jeffkub/beer-gauge/README.md

# beer-gauge
Digital scale with display for weighing beer left in a keg/kegerator
