jeffkub/beer-gauge/hardware/beer-gauge-bom.xlsx

Sheet: Main Board
Ref | Description | Source | Part # | Qty | Footprint | Notes
BT1 | HOLDER COIN CELL 12MM SMD | DigiKey | BK-885-CT-ND | 1 | footprint:BK-885
CON1 | CONN PWR JACK 2.0X5.5MM SMD | DigiKey | CP-070AHPJCT-ND | 1 | footprint:PJ-070AH-SMT
C1 | CAP TANT 220UF 16V 10% 2917 | DigiKey | 399-10429-1-ND | 1 | Capacitors_Tantalum_SMD:TantalC_SizeD_EIA-7343_Reflow
C2-C4,C6, C9-C14,C16,C17 | 0.10µF ±10% 25V X7R Ceramic Capacitor | DigiKey | 311-1341-1-ND | 12 | Capacitors_SMD:C_0603
C5,C7,C8,C15 | 2.2µF ±10% 10V X7R Ceramic Capacitor | DigiKey | 311-1797-1-ND | 4 | Capacitors_SMD:C_0603
C18 | CAP TANT 100UF 10V 20% 2917 | DigiKey | 399-3772-1-ND | 1 | Capacitors_Tantalum_SMD:TantalC_SizeD_EIA-7343_Reflow
D1 | LED RED CLEAR 0603 SMD | DigiKey | 754-1123-1-ND | 1 | LEDs:LED_0603
D2 | DIODE ARRAY SCHOTTKY 40V 3HUSON | DigiKey | 568-6524-1-ND | 1 | footprint:SOT1061
D3 | DIODE ZENER 6.2V 500MW SOD123 | DigiKey | DDZ6V2BDICT-ND | 1 | Diodes_SMD:SOD-123
D4 | DIODE GEN PURP 100V 1A SMA | DigiKey | S1B-FDICT-ND | 1 | Diodes_SMD:SMA_Standard
J1 | CONN FPC BOTTOM 20POS 1.00MM R/A | DigiKey | WM7946CT-ND | 2 | footprint:0522712069
L1-L3 | FERRITE BEAD 600 OHM 0603 1LN | DigiKey | 490-1014-1-ND | 3 | Resistors_SMD:R_0603
P1-P4 | CONN MOD JACK 4P4C VERT UNSHLD | DigiKey | WM3555CT-ND | 4 | footprint:0855135016
P5 | USB - micro B USB 2.0 Receptacle | DigiKey | 609-4613-1-ND | 1 | footprint:10118192
R1,R4,R5 | RES SMD 470 OHM 1% 1/10W 0603 | DigiKey | 311-470HRCT-ND | 3 | Resistors_SMD:R_0603
R2,R3 | RES SMD 33 OHM 1% 1/10W 0603 | DigiKey | 311-33.0HRCT-ND | 2 | Resistors_SMD:R_0603
R6-R13 | RES SMD 4.7K OHM 1% 1/10W 0603 | DigiKey | 311-4.70KHRCT-ND | 8 | Resistors_SMD:R_0603
SP1 | BUZZER PIEZO 12.5V 9MM SMD | DigiKey | 490-9647-1-ND | 1 | footprint:PKMCS
SW1 | SWITCH TACTILE SPST-NO 0.05A 32V | DigiKey | CKN10284CT-ND | 1 | Buttons_Switches_SMD:SW_SPST_KMR2
U1 | IC ADC 24-BIT 10/80SPS 24-TSSOP | DigiKey | 296-25894-1-ND | 1 | Housings_SSOP:TSSOP-24_4.4x7.8mm_Pitch0.65mm
U2 | IC REG LDO 3.3V 0.5A 6WSON | DigiKey | 296-42346-1-ND | 1 | Housings_DFN_QFN:DFN-6-1EP_3x3mm_Pitch0.95mm
U3 | MKL02 chip pre-programmed with Teensy bootloader | PJRC | IC_MKL02Z32_QFN16 | 1 | Housings_DFN_QFN:QFN-16-1EP_3x3mm_Pitch0.5mm | https://www.pjrc.com/store/ic_mkl02.html
U4 | IC MCU 32BIT 256KB FLASH 64LQFP | DigiKey | MK20DX256VLH7-ND | 1 | Housings_QFP:LQFP-64_10x10mm_Pitch0.5mm
U5 | IC I2C SW 2CH W/RESET 14TSSOP | DigiKey | 296-42157-1-ND | 1 | Housings_SSOP:TSSOP-14_4.4x5mm_Pitch0.65mm
U6 | IC MULT-FUNCTION GATE SC70-6 | DigiKey | 296-15577-1-ND | 1 | TO_SOT_Packages_SMD:SC-70-6
Y1 | 16MHz ±15ppm Crystal 8pF | DigiKey | 644-1049-1-ND | 1 | Crystals:Crystal_SMD_2520_4Pads
Y2 | 32.768kHz ±20ppm Crystal 12.5pF | DigiKey | 535-9542-1-ND | 1 | footprint:ABS07
- | CABLE FFC 1MM TYPE 2 20P100MM | DigiKey | 732-5134-ND | 1
- | BATTERY LITHIUM 3V COIN 12.5MM | DigiKey | P033-ND | 1
- | Monochrome 2.42" 128x64 OLED Graphic Display Module Kit | Adafruit | 2719 | 1 | https://www.adafruit.com/product/2719

Sheet: Sensor Board
Ref | Description | Source | Part # | Qty | Footprint | Notes
C1,C2 | 2.2µF ±10% 10V X7R Ceramic Capacitor | DigiKey | 311-1797-1-ND | 2 | Capacitors_SMD:C_0603
C3,C4 | 0.10µF ±10% 25V X7R Ceramic Capacitor | DigiKey | 311-1341-1-ND | 2 | Capacitors_SMD:C_0603
P1 | CONN MOD JACK 4P4C R/A UNSHLD | DigiKey | WM3544CT-ND | 1
R3,R4 | RES SMD 4.7K OHM 1% 1/10W 0603 | DigiKey | 311-4.70KHRCT-ND | 2 | Resistors_SMD:R_0603
U1 | IC REG LDO 3.3V 0.5A 6WSON | DigiKey | 296-42346-1-ND | 1 | Housings_DFN_QFN:DFN-6-1EP_3x3mm_Pitch0.95mm
U2 | SENSOR TEMP I2C/SMBUS 8DFN | DigiKey | MCP9808T-E/MCCT-ND | 1
U3 | SENSOR PRESSURE 30 PSIG | DigiKey | 480-6247-ND | 1
