jeffkub/beer-gauge/enclosure/EnclosureLaserCut.dxf

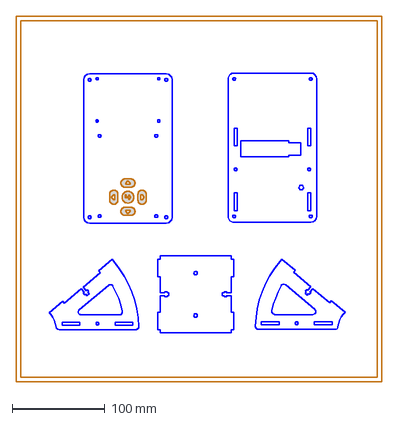
[picture p1: CAD file, 2016-07-14]
enclosure/EnclosureLaserCut.dxf
394.0 x 394.0 mm
