jeffkub/beer-gauge/(list of files, cad)

Other CAD files:
enclosure/BackCover.ipt
enclosure/EnclosureAssembly.iam
enclosure/EnclosureDrawing.idw
enclosure/FrontCover.ipt
enclosure/Magnet.ipt
enclosure/MountBase.ipt
enclosure/SideMount.ipt
