jeffkub/beer-gauge/hardware/beer-gauge.pdf

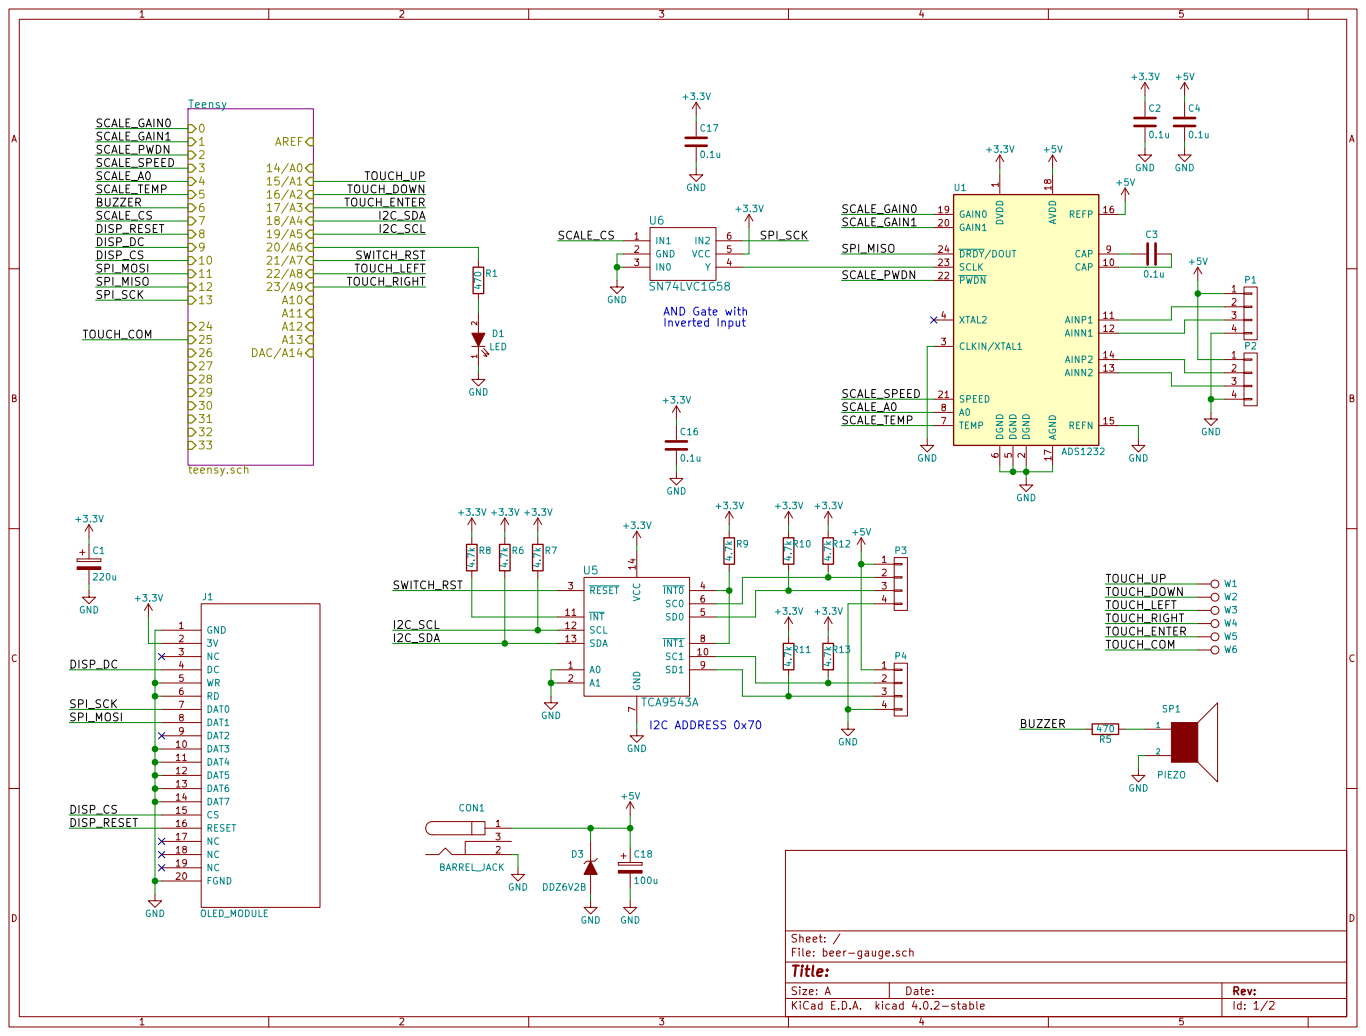
[picture p2: page 1]

6 TEMP 7 A0 8 CAP 9 CAP 10 GAIN1 20 AINP1 11 SPEED 21 AINN1 12 PWDN 22 AINN2 13 SCLK 23 AINP2 14 DRDY/DOUT 24 REFN 15 REFP 16 AGND 17 AVDD 18 GAIN0 19 U1 ADS1232 GND
SCALE_GAIN0
SCALE_GAIN1

TOUCH_LEFT
TOUCH_RIGHT

I2C_SDA

File: beer-gauge.sch Sheet: /

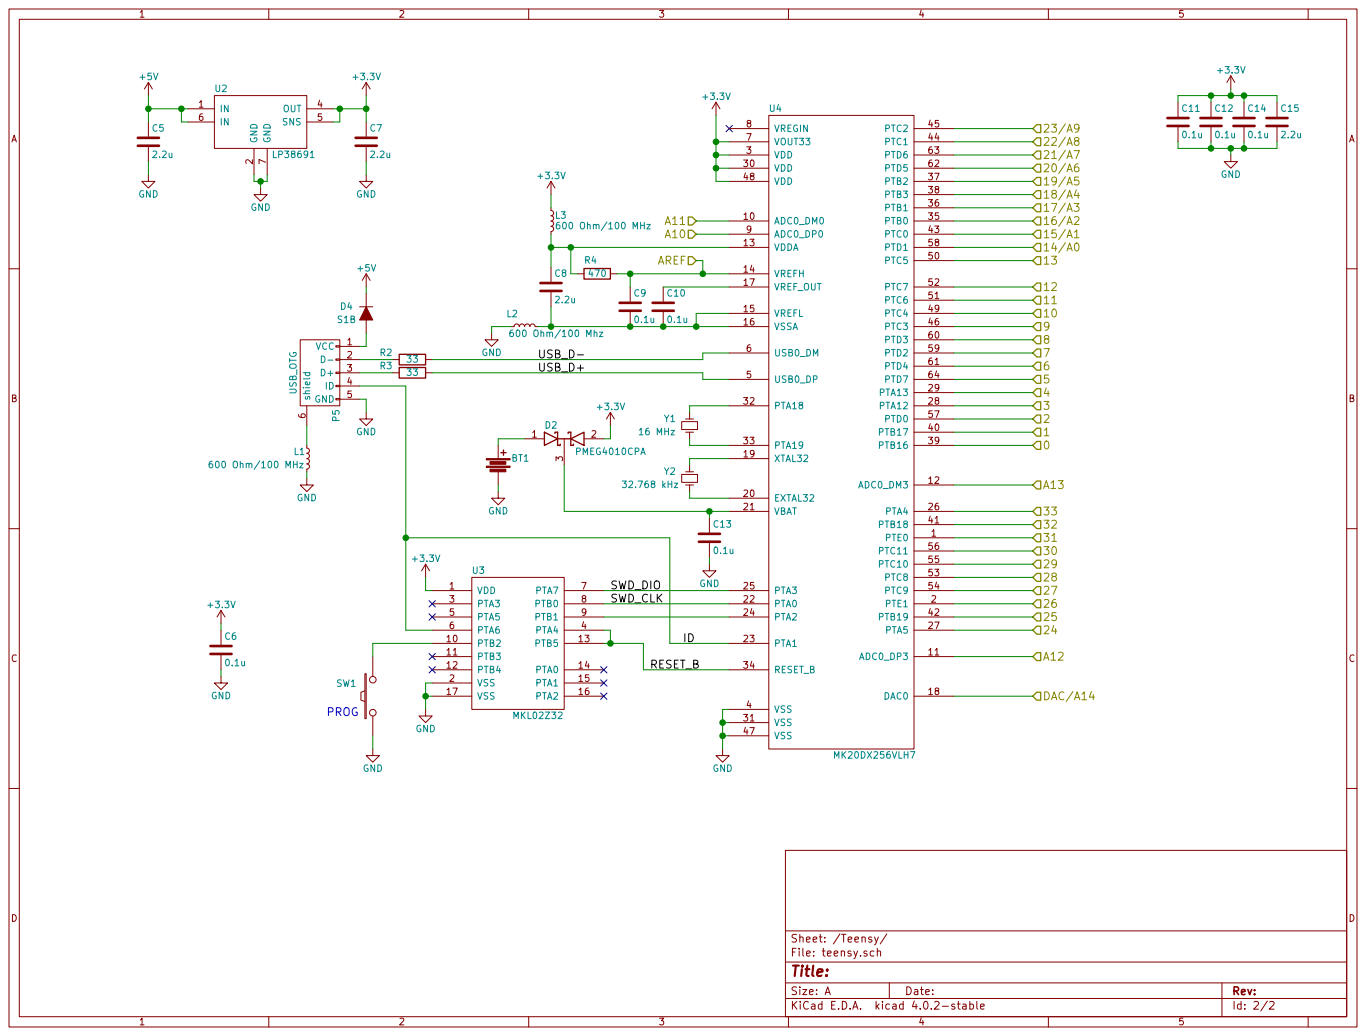
[picture p3: page 2]
