jeffkub/beer-gauge/sensorboard/sensorboard.pdf

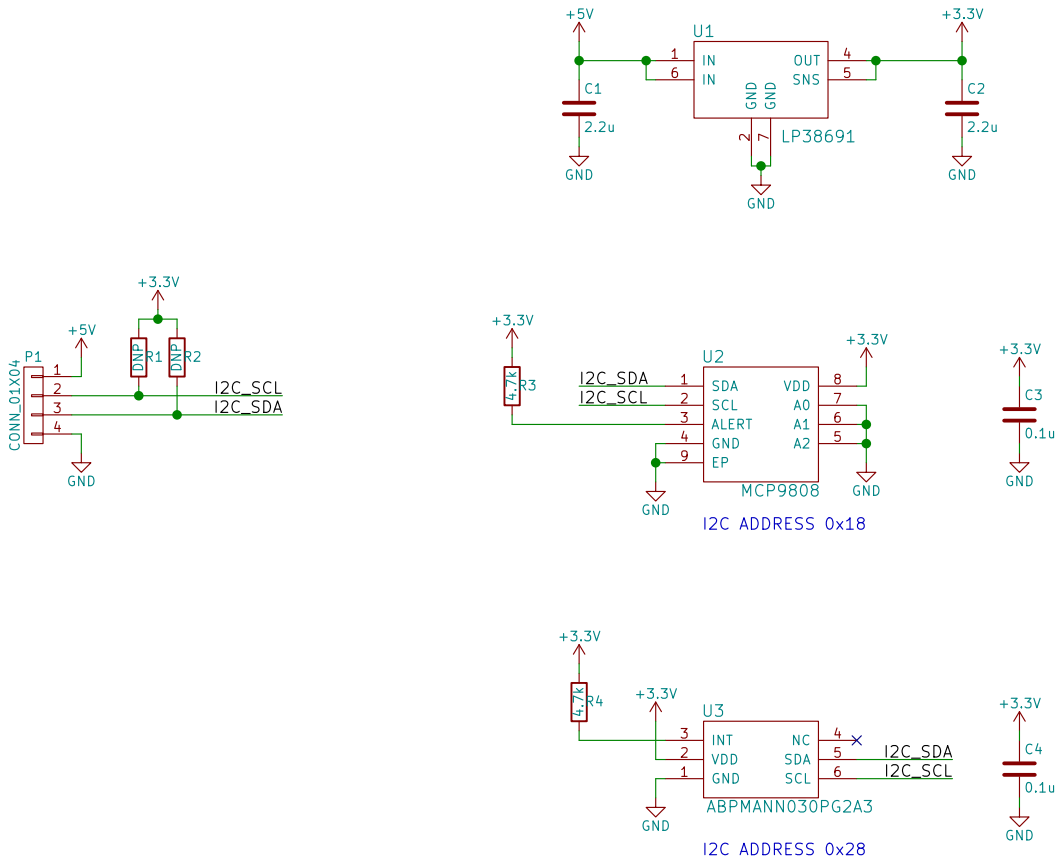
[picture p4: page 1]

I2C_SCL

Id: 1/1 Title: File: sensorboard.sch Sheet: /
