jeffkub/beer-gauge/sensorboard/sensorboard.kicad_pcb

## KiCad design sensorboard/sensorboard.kicad_pcb (2016-07-09)

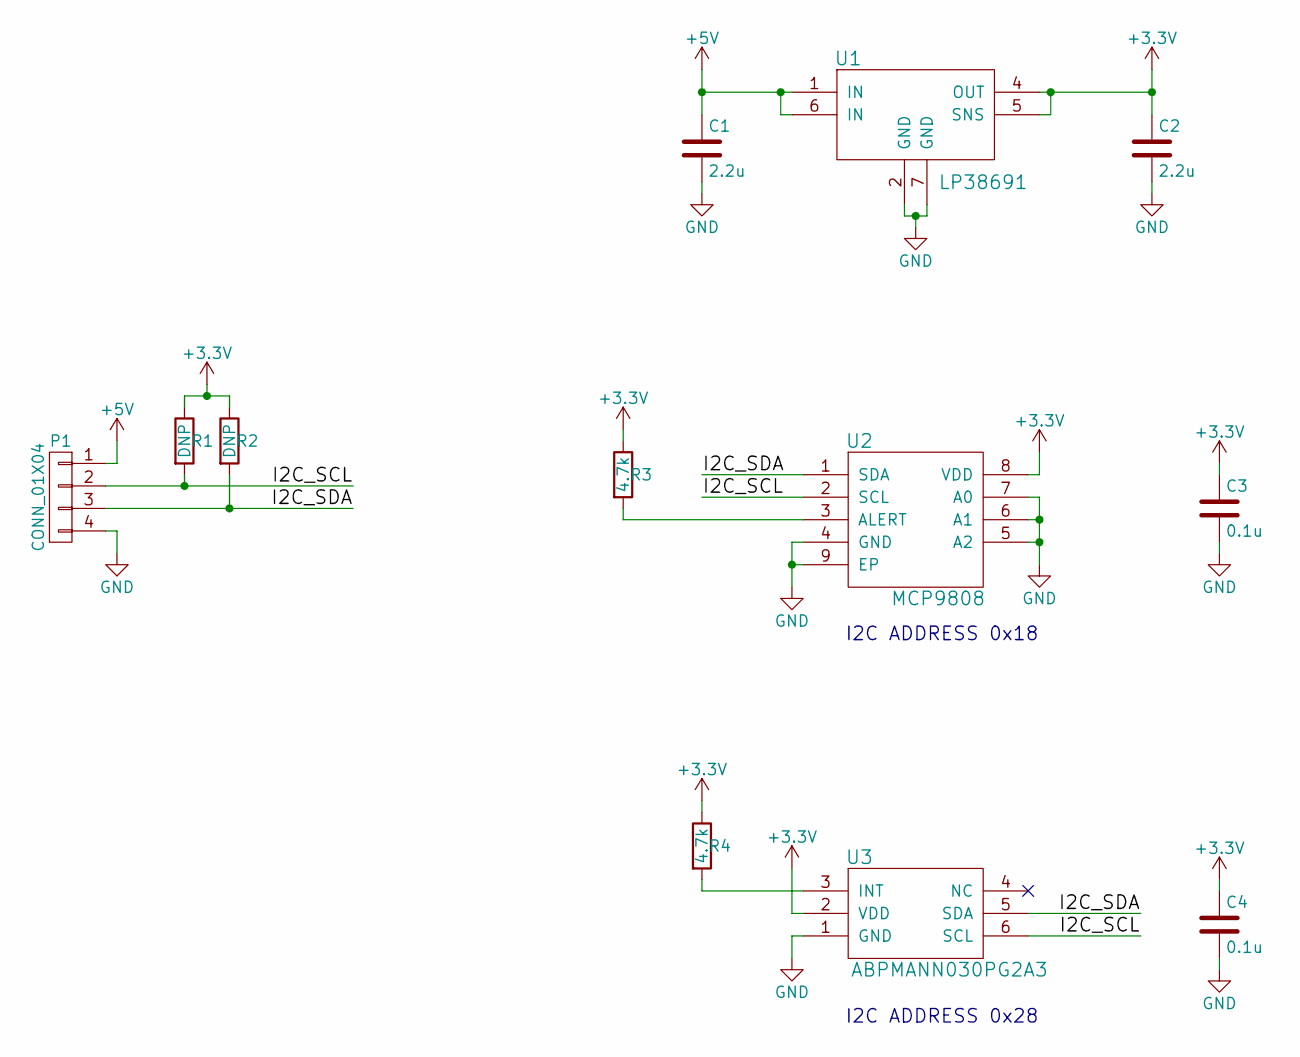
[picture p5: schematic sensorboard.sch]

Parts:
C1, C2: 2.2u; C_0603
C3, C4: 0.1u; C_0603
P1: CONN_01X04; 0855025005
R1, R2: DNP; R_0603
R3, R4: 4.7k; R_0603
U1: LP38691; DFN-6-1EP_3x3mm_Pitch0.95mm
U2: MCP9808; DFN-8-1EP_3x2mm_Pitch0.5mm
U3: ABPMANN030PG2A3

Connections:
+3V3: C2.1, C3.1, C4.1, R1.1, R2.1, R3.1, R4.1, U1.4 (OUT), U1.5 (SNS), U2.8 (VDD), U3.2 (VDD)
+5V: C1.1, P1.1, U1.1 (IN), U1.6 (IN)
/I2C_SCL: P1.2, R1.2, U2.2 (SCL), U3.6 (SCL)
/I2C_SDA: P1.3, R2.2, U2.1 (SDA), U3.5 (SDA)
GND: C1.2, C2.2, C3.2, C4.2, P1.4, U1.2 (GND), U1.7 (GND), U2.4 (GND), U2.5 (A2), U2.6 (A1), U2.7 (A0), U2.9 (EP), U3.1 (GND)
unnamed: R3.2, U2.3 (ALERT)
unnamed: R4.2, U3.3 (INT)

Notes on the sheet:
I2C ADDRESS 0x18
I2C ADDRESS 0x28

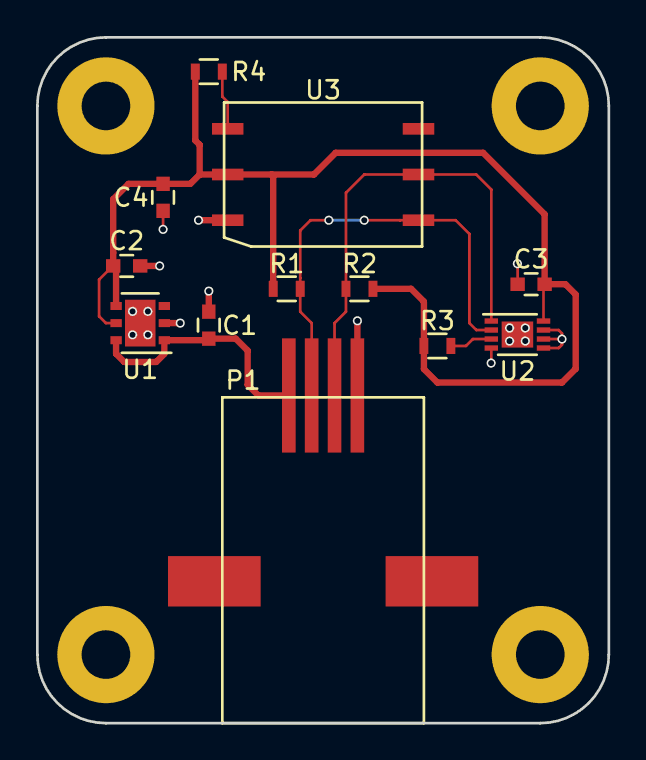
[picture p6: board sensorboard.kicad_pcb from above]

Board: 2 copper layers, 31.8 x 38.1 mm, 12 parts (0 on the bottom side), 7 nets.
