jeffkub/beer-gauge/hardware/beer-gauge.kicad_pcb

## KiCad design hardware/beer-gauge.kicad_pcb (2016-07-09)

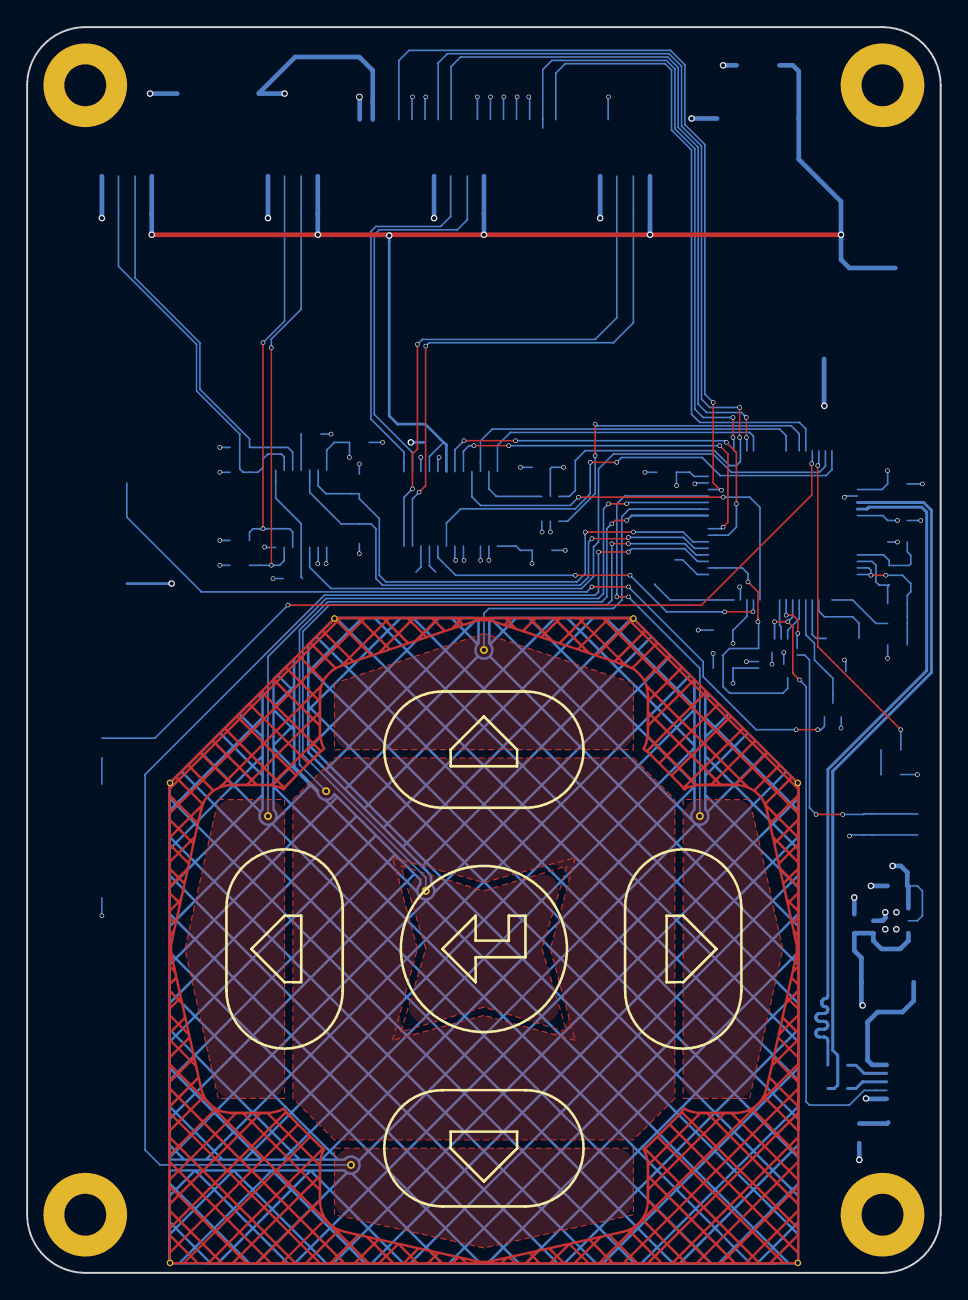
[picture p7: board beer-gauge.kicad_pcb from above]

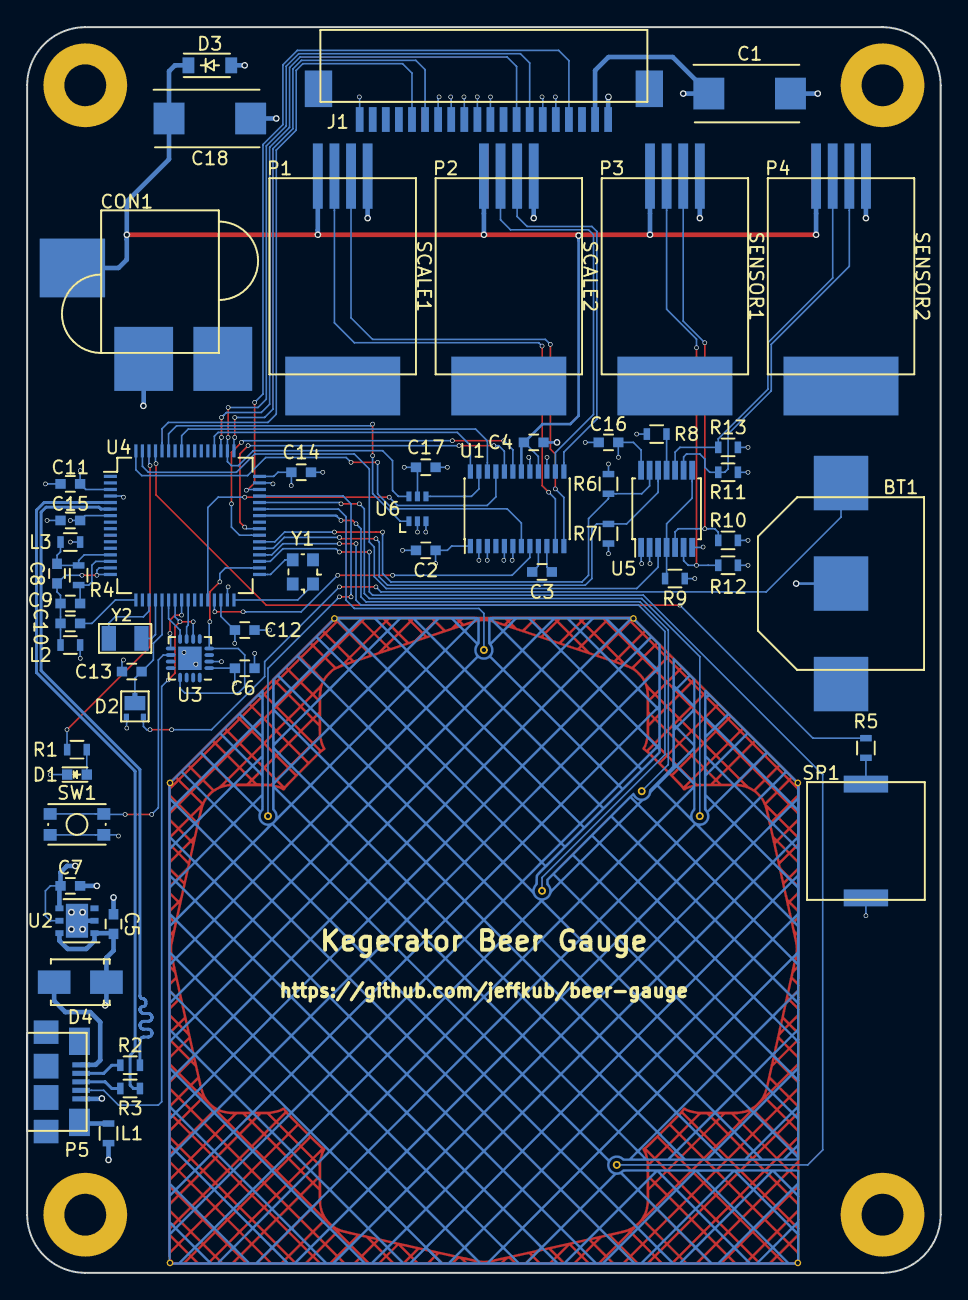
[picture p8: board beer-gauge.kicad_pcb from below]

Board: 4 copper layers, 69.8 x 95.2 mm, 62 parts (56 on the bottom side), 64 nets.

Parts:
BT1: Battery; BK-885
C1: 220u; TantalC_SizeD_EIA-7343_Reflow
C2, C3, C4, C6, C9, C10, C11, C12, C13, C14, C16, C17: 0.1u; C_0603
C5, C7, C8, C15: 2.2u; C_0603
C18: 100u; TantalC_SizeD_EIA-7343_Reflow
CON1: BARREL_JACK; PJ-070AH-SMT
D1: LED; LED_0603
D2: PMEG4010CPA; SOT1061
D3: DDZ6V2B; SOD-123
D4: S1B; SMA_Standard
J1: OLED_MODULE; 0522712069
L1, L3: 600 Ohm/100 MHz; R_0603
L2: 600 Ohm/100 Mhz; R_0603
P1, P2, P3, P4: CONN_01X04; 0855135016
P5: USB_OTG; 10118192
R1, R4, R5: 470; R_0603
R2, R3: 33; R_0603
R6, R7, R8, R9, R10, R11, R12, R13: 4.7k; R_0603
SP1: PIEZO; PKMCS
SW1: SW_PUSH; SW_SPST_KMR2
U1: ADS1232; TSSOP-24_4.4x7.8mm_Pitch0.65mm
U2: LP38691; DFN-6-1EP_3x3mm_Pitch0.95mm
U3: MKL02Z32; QFN-16-1EP_3x3mm_Pitch0.5mm
U4: MK20DX256VLH7; LQFP-64_10x10mm_Pitch0.5mm
U5: TCA9543A; TSSOP-14_4.4x5mm_Pitch0.65mm
U6: SN74LVC1G58; SC-70-6
W1, W2, W3, W4, W5, W6: TEST_1P; PadVia
Y1: 16 MHz; Crystal_SMD_2520_4Pads
Y2: 32.768 kHz; ABS07

Connections:
+3V3: C1.1, C2.1, C6.1, C7.1, C11.1, C12.1, C14.1, C15.1, C16.1, C17.1, D2.2, J1.2, L3.1, R6.1, R7.1, R8.1, R9.1, R10.1, R11.1, R12.1, R13.1, U1.1, U2.4, U2.5, U3.1, U4.3, U4.7, U4.30, U4.48, U5.14, U6.5
+5V: C4.1, C5.1, C18.1, CON1.1, D3.1, D4.1, P1.1, P2.1, P3.1, P4.1, U1.16, U1.18, U2.1, U2.6
/Teensy/0: U1.19, U4.39
/Teensy/1: U1.20, U4.40
/Teensy/2: U1.22, U4.57
/Teensy/3: U1.21, U4.28
/Teensy/4: U1.8, U4.29
/Teensy/5: U1.7, U4.64
/Teensy/6: R5.2, U4.61
/Teensy/7: U4.59, U6.1
/Teensy/8: J1.16, U4.60
/Teensy/9: J1.4, U4.46
/Teensy/10: J1.15, U4.49
/Teensy/11: J1.8, U4.51
/Teensy/12: U1.24, U4.52
/Teensy/13: J1.7, U4.50, U6.6
/Teensy/15/A1: U4.43, W1.1
/Teensy/16/A2: U4.35, W2.1
/Teensy/17/A3: U4.36, W5.1
/Teensy/18/A4: R6.2, U4.38, U5.13
/Teensy/19/A5: R7.2, U4.37, U5.12
/Teensy/20/A6: R1.1, U4.62
/Teensy/21/A7: U4.63, U5.3
/Teensy/22/A8: U4.44, W3.1
/Teensy/23/A9: U4.45, W4.1
/Teensy/25: U4.42, W6.1
/Teensy/AREF: C9.1, R4.1, U4.14
/Teensy/ID: P5.4, U3.6, U4.23
/Teensy/RESET_B: U3.4, U3.13, U4.34
/Teensy/SWD_CLK: U3.8, U4.22
/Teensy/SWD_DIO: U3.7, U4.25
/Teensy/USB_D+: R3.1, U4.5
/Teensy/USB_D-: R2.1, U4.6
GND: BT1.2, C1.2, C2.2, C4.2, C5.2, C6.2, C7.2, C11.2, C12.2, C13.2, C14.2, C15.2, C16.2, C17.2, C18.2, CON1.2, D1.1, D3.2, J1.1, J1.5, J1.6, J1.10, J1.11, J1.12, J1.13, J1.14, J1.20, L1.2, L2.1, P1.4, P2.4, P3.4, P4.4, P5.5, SP1.2, SW1.1, U1.2, U1.3, U1.5, U1.6, U1.15, U1.17, U2.2, U2.7, U3.2, U3.17, U4.4, U4.31, U4.47, U5.1, U5.2, U5.7, U6.2, U6.3
unnamed: BT1.1, D2.1
unnamed: C3.1, U1.9
unnamed: C3.2, U1.10
unnamed: C8.1, L3.2, R4.2, U4.13
unnamed: C10.1, U4.17
unnamed: C8.2, C9.2, C10.2, L2.2, U4.15, U4.16
unnamed: C13.1, D2.3, U4.21
unnamed: D1.2, R1.2
unnamed: D4.2, P5.1
unnamed: L1.1, P5.6
unnamed: P1.2, U1.11
unnamed: P1.3, U1.12
unnamed: P2.2, U1.14
unnamed: P2.3, U1.13
unnamed: P3.2, R12.2, U5.6
unnamed: P3.3, R10.2, U5.5
unnamed: P4.2, R13.2, U5.10
unnamed: P4.3, R11.2, U5.9
unnamed: P5.2, R2.2
unnamed: P5.3, R3.2
unnamed: R5.1, SP1.1
unnamed: R8.2, U5.11
unnamed: R9.2, U5.4, U5.8
unnamed: SW1.2, U3.10
unnamed: U1.23, U6.4
unnamed: U3.9, U4.24
unnamed: U4.19, Y2.1
unnamed: U4.20, Y2.2
unnamed: U4.32, Y1.1
unnamed: U4.33, Y1.2
