jeffkub/beer-gauge/(commit log)

2016-06-11 Initial commit of KiCad project
    [beer-gauge.kicad_pcb, beer-gauge.sch]
2016-06-14 Created TEENSY footprint
    [beer-gauge.sch]
2016-06-16 Added subsheet for TEENSY schematic. Working on TEENSY circuit based on online reference design.
    [beer-gauge.sch, teensy.sch]
2016-06-17 Working on schematic
    [beer-gauge.sch, teensy.sch]
2016-06-17 Created schematic PDF. Working on BOM.
    [BillOfMaterials.xlsx, beer-gauge.sch, teensy.sch]
2016-06-19 Working on BOM.
    [BillOfMaterials.xlsx, beer-gauge-bom.xlsx, beer-gauge.sch, teensy.sch]
2016-06-19 Added piezo transducer. Working on footprints
    [beer-gauge-bom.xlsx, beer-gauge.sch, teensy.sch]
2016-06-19 Working on capacitive touch pad. Added footprint for piezo
    [beer-gauge-bom.xlsx, beer-gauge.sch, teensy.sch]
2016-06-20 Added footprint for coin cell battery holder and RJ10 jack
    [beer-gauge-bom.xlsx, beer-gauge.sch, teensy.sch]
2016-06-21 Working on footprints. Exported netlist into layout.
    [beer-gauge-bom.xlsx, beer-gauge.kicad_pcb, beer-gauge.sch, teensy.sch]
2016-06-22 Finished footprints. Switched to a tantalum cap for the LCD. Changed piezo resistor value to 470 to reduce part count.
    [beer-gauge-bom.xlsx, beer-gauge.kicad_pcb, beer-gauge.sch]
2016-06-22 Working on capacitive touch arrow pad layout
    [beer-gauge.kicad_pcb]
2016-06-23 Working on component placement
    [beer-gauge.kicad_pcb]
2016-06-24 Working on PCB layout
    [beer-gauge.kicad_pcb]
2016-06-26 Finished routing traces
    [beer-gauge.kicad_pcb]
2016-06-26 Finished routing the board
    [beer-gauge.kicad_pcb]
2016-06-27 Added RTC battery to BOM. Fixed BOM quantities
    [beer-gauge-bom.xlsx]
2016-06-27 Initial commit of arduino code
2016-06-30 Working on ADC driver library
2016-06-30 Added some silkscreen text. Adjusted soldermask clearance as it was too large.
    [beer-gauge.kicad_pcb]
2016-07-06 Changed OLED display to use SPI interface in schematic
    [beer-gauge.sch, teensy.sch]
2016-07-06 Updating schematic/BOM to use 2 channel ADC, added I2C switch
    [beer-gauge-bom.xlsx, beer-gauge.kicad_pcb, beer-gauge.sch, teensy.sch]
2016-07-06 Updating layout with schematic changes
    [beer-gauge.kicad_pcb, beer-gauge.sch]
2016-07-07 Finished layout of traces
    [beer-gauge.kicad_pcb, beer-gauge.sch]
2016-07-07 Minor fixes to layout
    [beer-gauge.kicad_pcb]
2016-07-08 Added DC jack for 5V input. Updated layout
    [beer-gauge-bom.xlsx, beer-gauge.kicad_pcb, beer-gauge.sch, teensy.sch]
2016-07-09 Minor tweaks to layout
    [beer-gauge.kicad_pcb]
2016-07-09 Created kicad project and schematic for I2C sensor board
    [beer-gauge.sch, sensorboard.kicad_pcb, sensorboard.sch]
2016-07-09 Finished layout of sensor board
    [sensorboard.kicad_pcb, sensorboard.sch]
2016-07-09 Updated BOM with sensor board parts
    [beer-gauge-bom.xlsx]
2016-07-09 Minor changes to sensor board layout
    [sensorboard.kicad_pcb]
2016-07-10 Working on acrylic enclosure design
    [BackCover.ipt, EnclosureAssembly.iam, FrontCover.ipt, Magnet.ipt, MountBase.ipt, SideMount.ipt]
2016-07-11 Working on acrylic enclosure
    [BackCover.ipt, EnclosureAssembly.iam, EnclosureDrawing.idw, EnclosureLaserCut.dxf]
2016-07-12 Fixed hatching issue
    [EnclosureLaserCut.dxf]
2016-07-12 Updated pin assignments based on REV2 design
2016-07-13 Split hatched filled arcs into many lines to address DFM problems
    [EnclosureLaserCut.dxf]
2016-07-14 Added a hole for access to programming pushbutton
    [BackCover.ipt, EnclosureAssembly.iam, EnclosureDrawing.idw, EnclosureLaserCut.dxf]
